Mustafa-8/Autonomous-Line-Follower-Mechatronics/(commit log)

2026-05-14 Add line follower firmware with PD control
    Implement a 5-sensor line follower with PD control for differential drive using Arduino and TB6612FNG motor driver.
2026-05-14 Update README with project description
    Updated project title and provided detailed project description, features, hardware specifications, wiring instructions, algorithm overview, project status, known limitations, future work, repository structure, documentation, team members, license, and acknowledgments.
